yJjDoAZuae/modular-sUAS/README.md

# modular-sUAS
A modular system of components for radio control aircraft and small uncrewed aircraft systems
