yJjDoAZuae/modular-sUAS/doc/design/cowl_interior_surface.md

# Cowl interior surface — the algorithm

*IP-FC-16. Written 2026-08-21, once [OQ-ARCH-17](../architecture/freecad_migration.md#open-questions)
removed the last undecided item.*

The cowl today is a solid blank with channels cut into it. It has no wall
([cowl.md §6.2](cowl.md)), which is sufficient for printing and insufficient for everything
else: a blank has no mass to report, no wall to analyze, and nothing to assemble against.
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
