yJjDoAZuae/modular-sUAS/doc/design/img/cowl_rib_cut/cw24_crowding_section.png

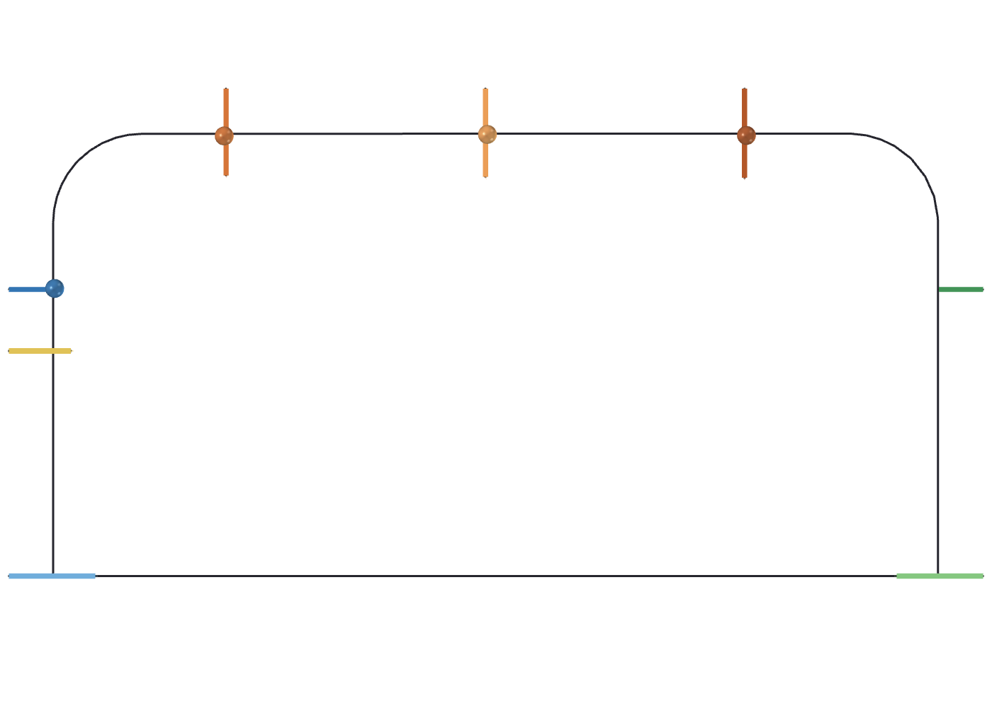
doc/design/img/cowl_rib_cut/cw24_crowding_section.png
