yJjDoAZuae/modular-sUAS/doc/design/img/cowl_rib_cut/cw24_overlap_context.png

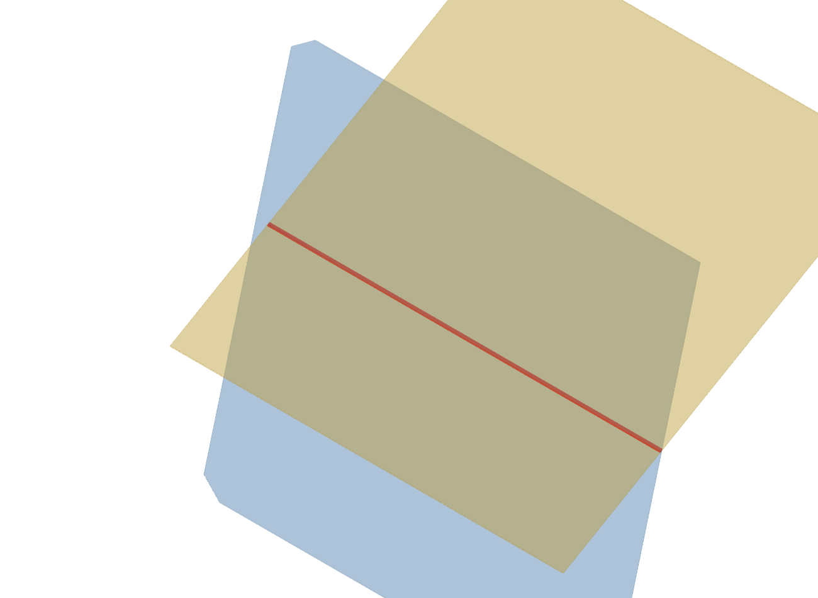
doc/design/img/cowl_rib_cut/cw24_overlap_context.png
