yJjDoAZuae/modular-sUAS/doc/design/img/cowl_rib_cut/cw24_wall_corrupt.png

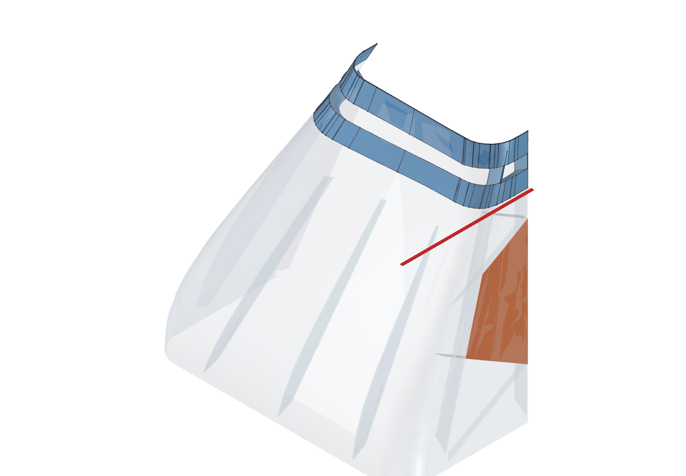
doc/design/img/cowl_rib_cut/cw24_wall_corrupt.png
