yJjDoAZuae/modular-sUAS/doc/design/img/cowl_rib_cut/cw25_section_crossing.png

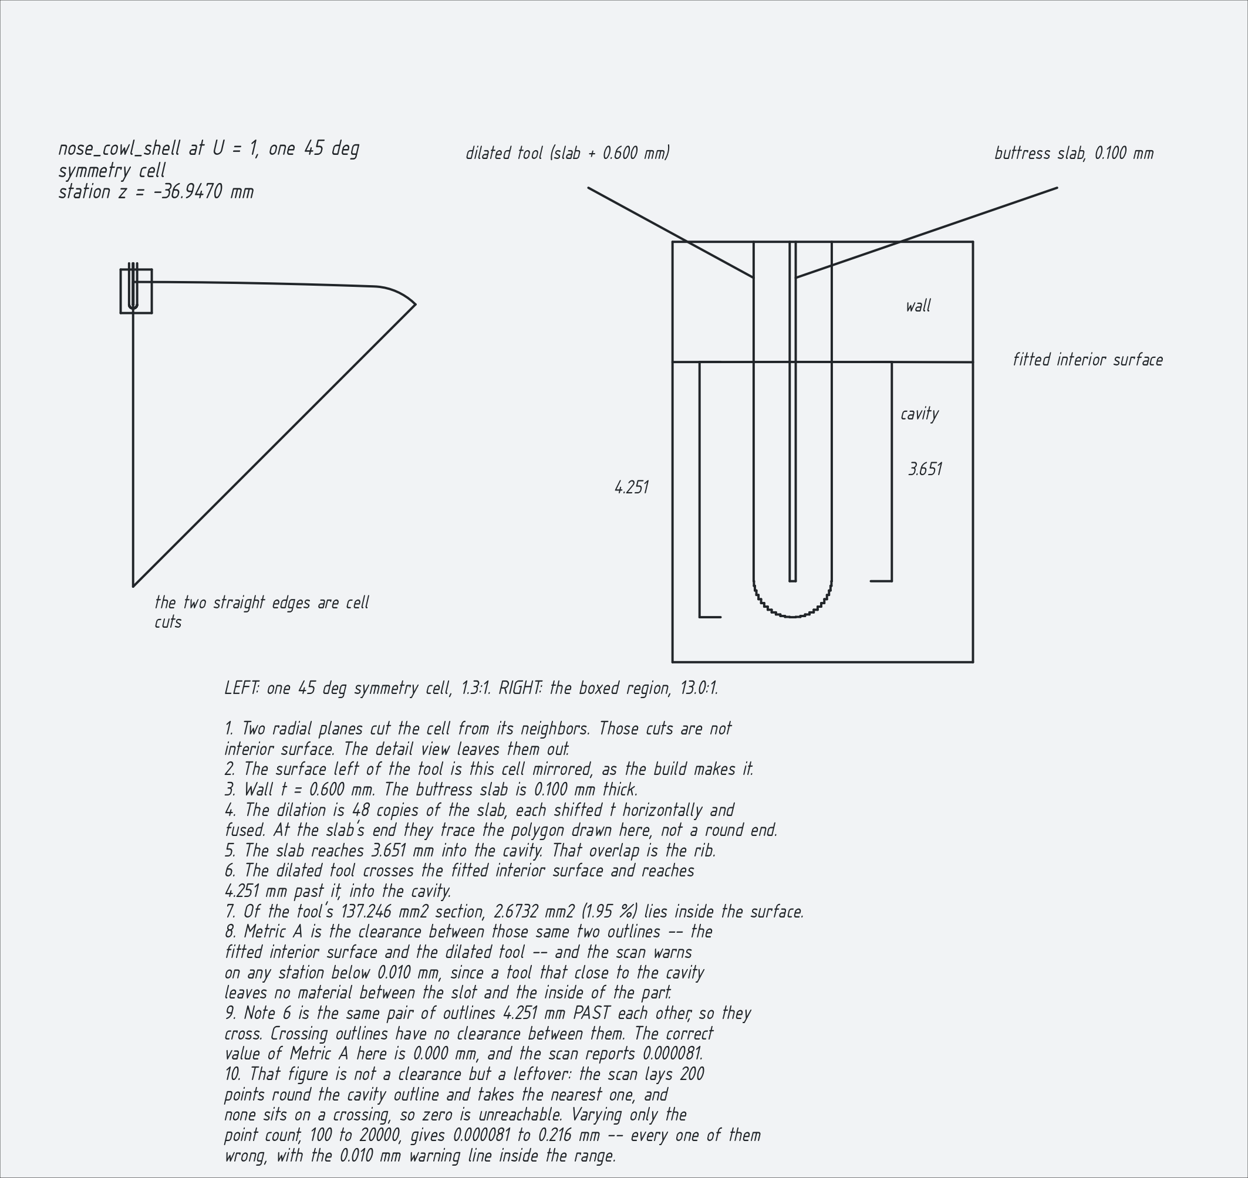
doc/design/img/cowl_rib_cut/cw25_section_crossing.png
