yJjDoAZuae/modular-sUAS/doc/wiki/fd1/media/fuse_splode.png

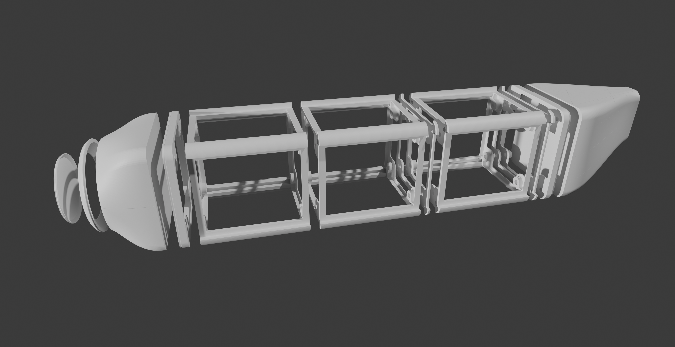
doc/wiki/fd1/media/fuse_splode.png
