yJjDoAZuae/modular-sUAS/media/16mm_collet/16mm_collet_hole_dimensions.png

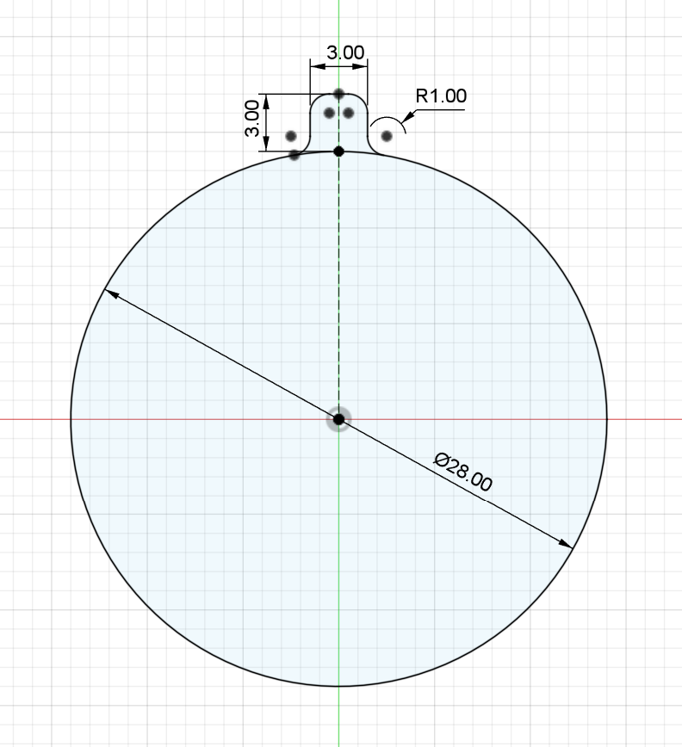
media/16mm_collet/16mm_collet_hole_dimensions.png
