yJjDoAZuae/modular-sUAS/media/16mm_collet/IMG_4695.jpg

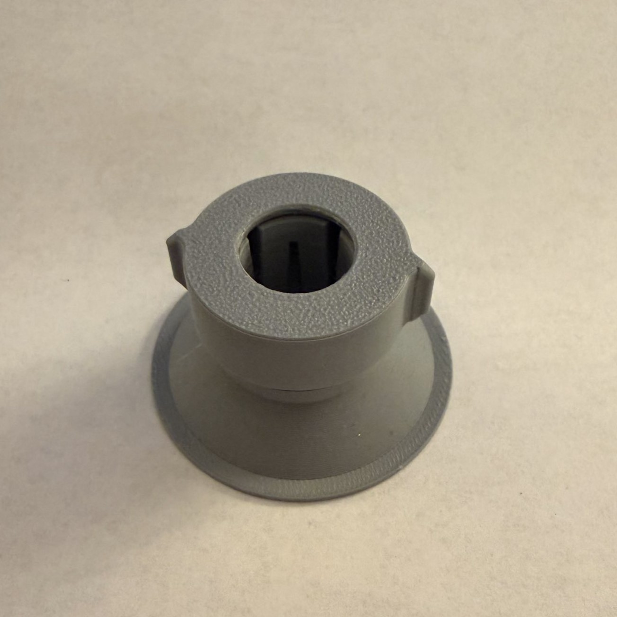
media/16mm_collet/IMG_4695.jpg
