yJjDoAZuae/modular-sUAS/media/boom_clamp/boom_clamp_bushing_outer_dimensions.png

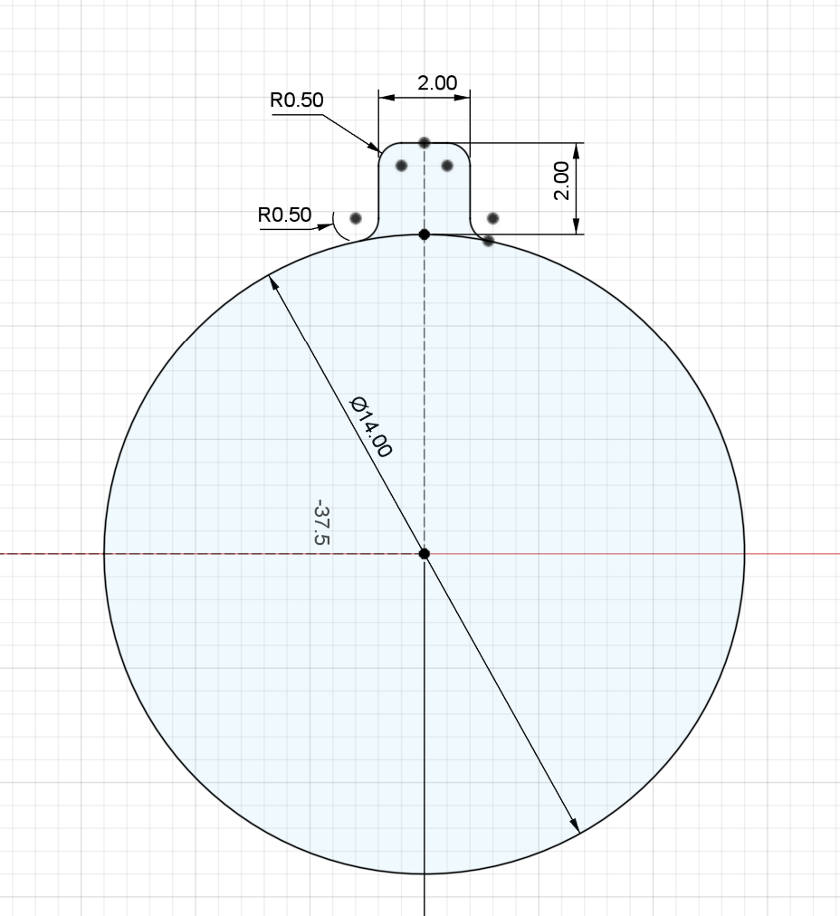
media/boom_clamp/boom_clamp_bushing_outer_dimensions.png
