yJjDoAZuae/modular-sUAS/media/boom_clamp/IMG_4647.jpg

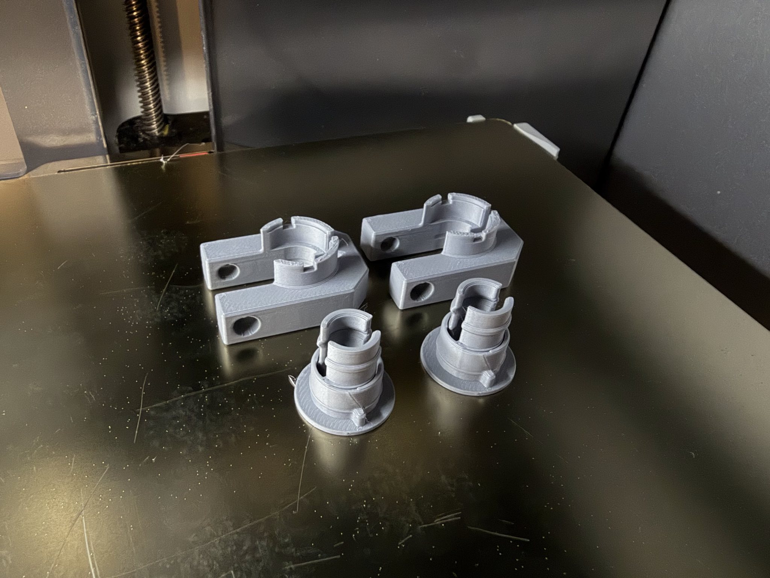
media/boom_clamp/IMG_4647.jpg
