yJjDoAZuae/modular-sUAS/media/boom_clamp/IMG_4653.jpg

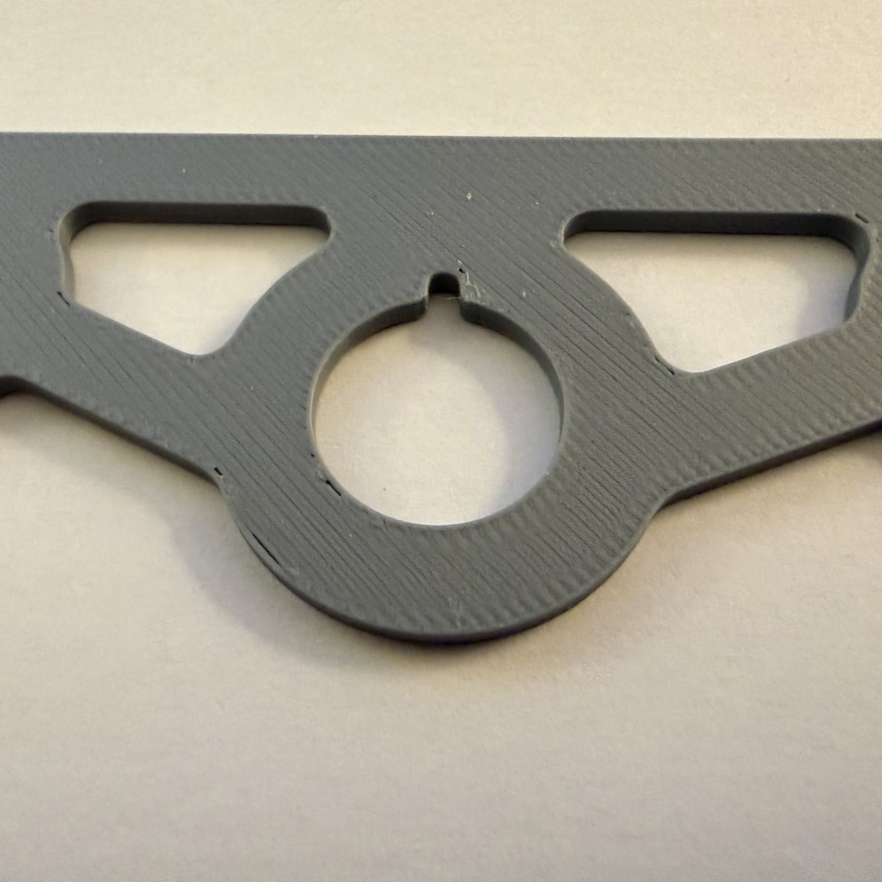
media/boom_clamp/IMG_4653.jpg
