yJjDoAZuae/modular-sUAS/media/boom_clamp/IMG_4656.jpg

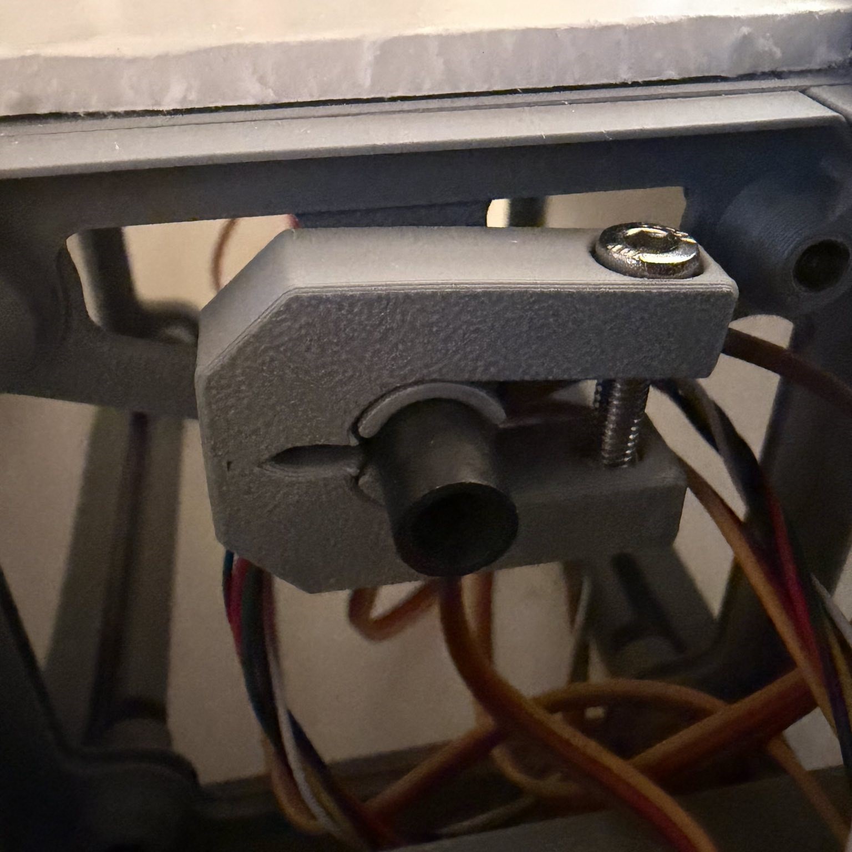
media/boom_clamp/IMG_4656.jpg
