yJjDoAZuae/modular-sUAS/media/bulkhead_corner/IMG_4622.jpg

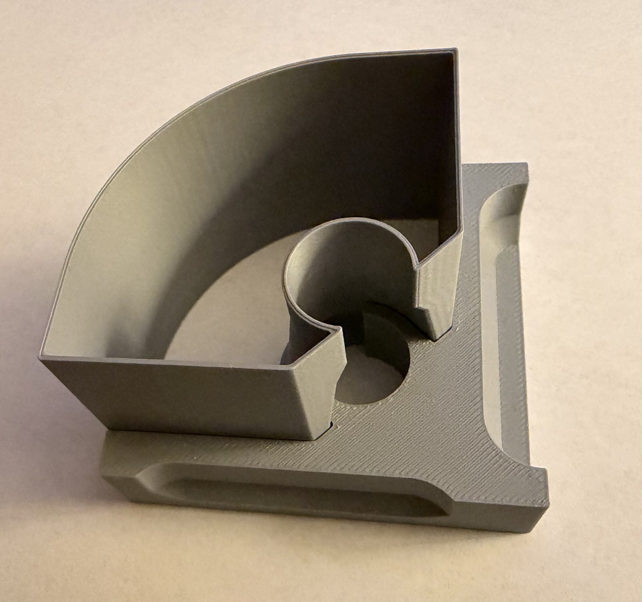
media/bulkhead_corner/IMG_4622.jpg
