yJjDoAZuae/modular-sUAS/media/nose_tail/IMG_4635.jpg

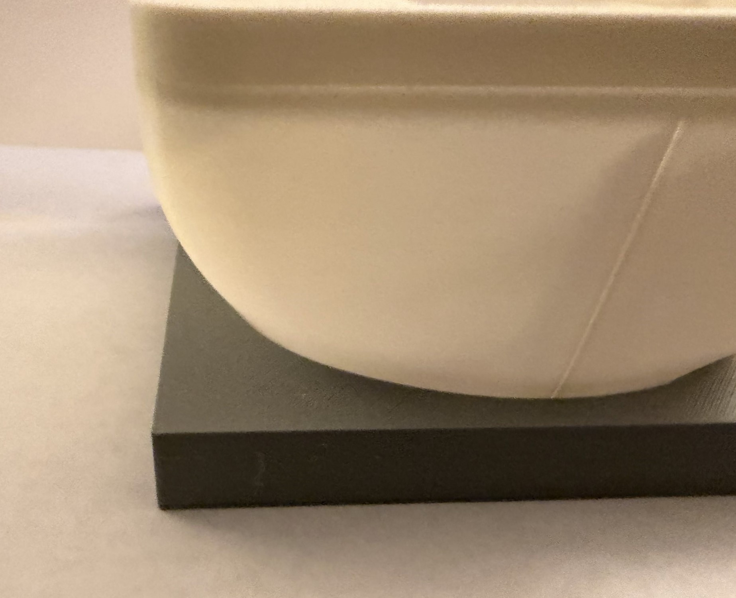
media/nose_tail/IMG_4635.jpg
