yJjDoAZuae/modular-sUAS/media/nose_tail/IMG_4636.jpg

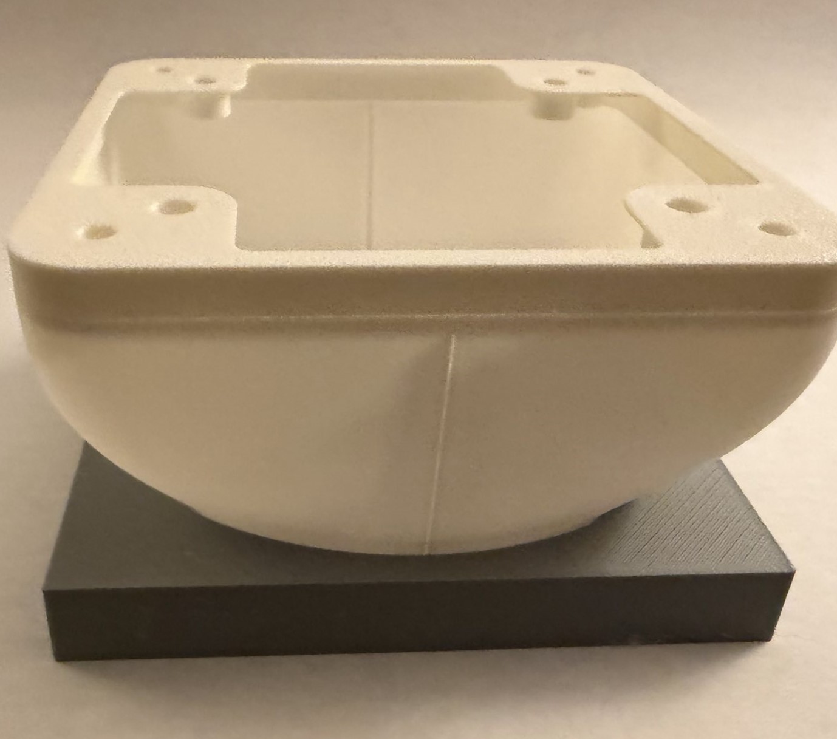
media/nose_tail/IMG_4636.jpg
