yJjDoAZuae/modular-sUAS/media/nose_tail/IMG_4641.jpg

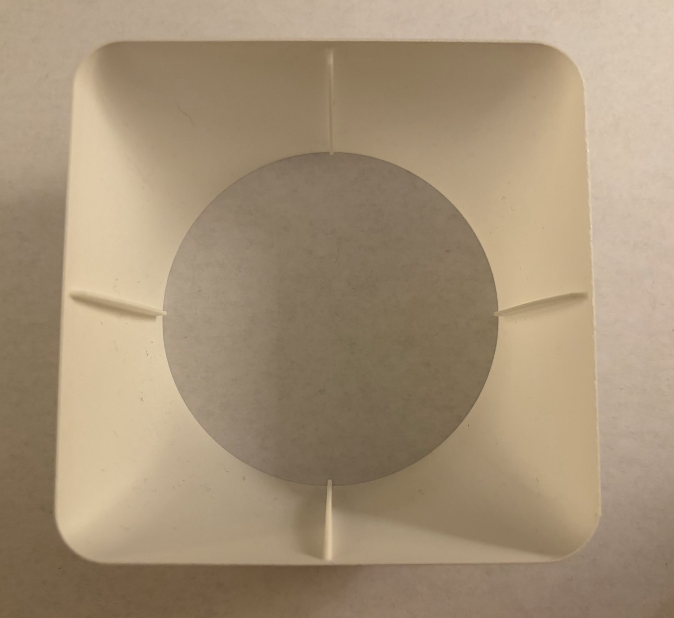
media/nose_tail/IMG_4641.jpg
