yJjDoAZuae/modular-sUAS/media/nose_tail/IMG_4642.jpg

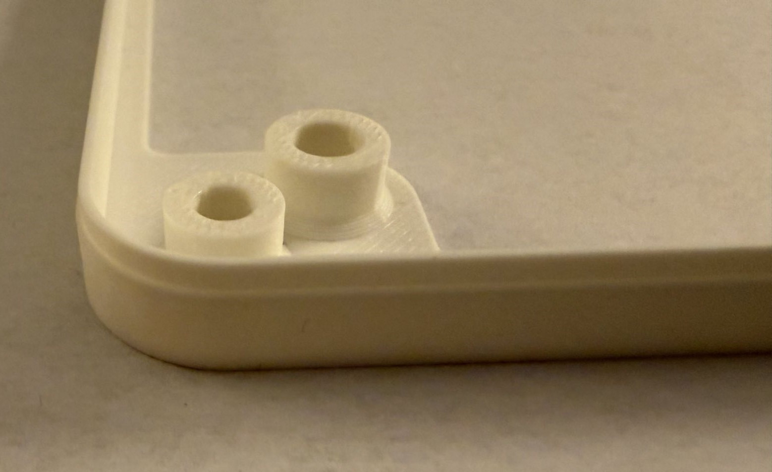
media/nose_tail/IMG_4642.jpg
