yJjDoAZuae/modular-sUAS/media/nose_tail/IMG_4644.jpg

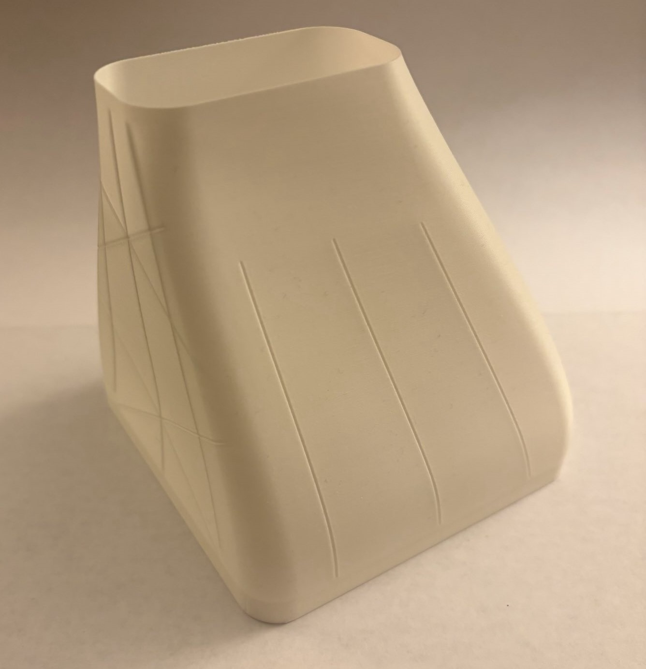
media/nose_tail/IMG_4644.jpg
