yJjDoAZuae/modular-sUAS/media/nose_tail/IMG_4645.jpg

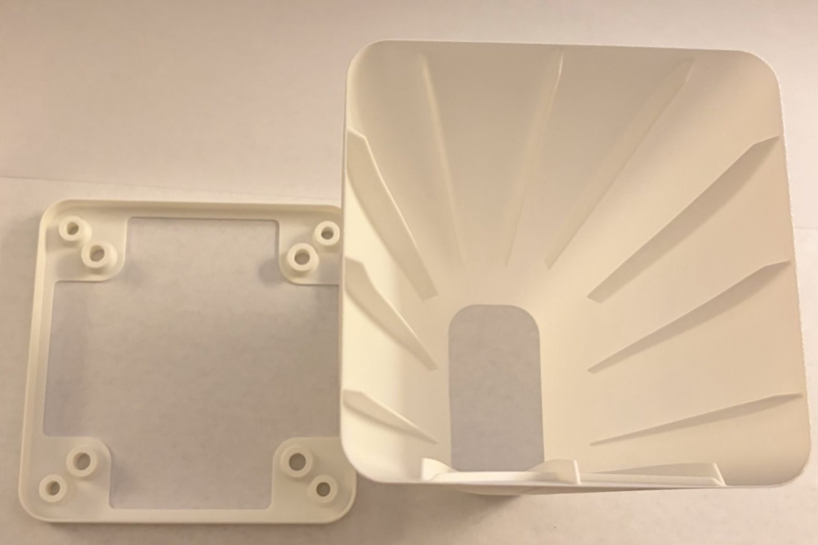
media/nose_tail/IMG_4645.jpg
