yJjDoAZuae/modular-sUAS/media/nose_tail/IMG_4658.jpg

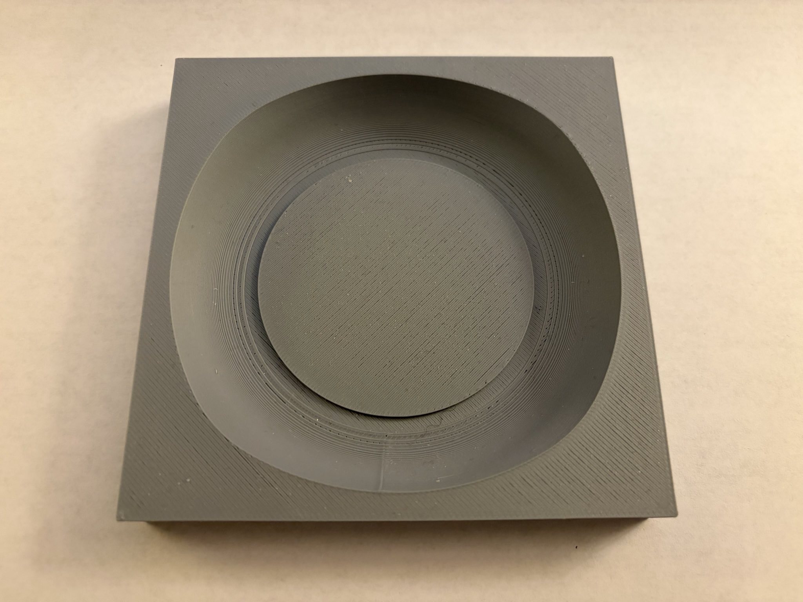
media/nose_tail/IMG_4658.jpg
