yJjDoAZuae/modular-sUAS/media/nose_tail/IMG_4662.jpg

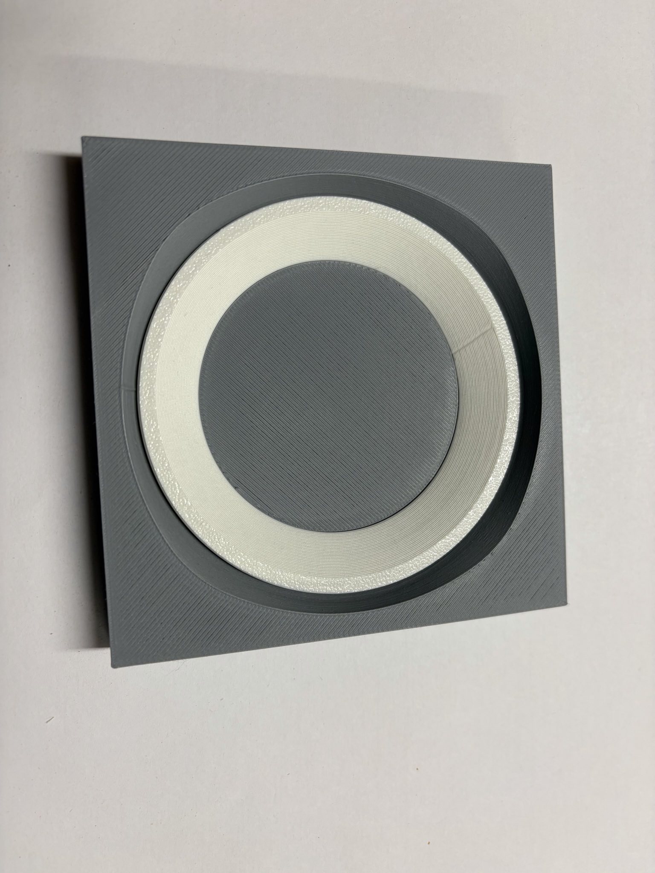
media/nose_tail/IMG_4662.jpg
