yJjDoAZuae/modular-sUAS/media/nose_tail/IMG_4665.jpg

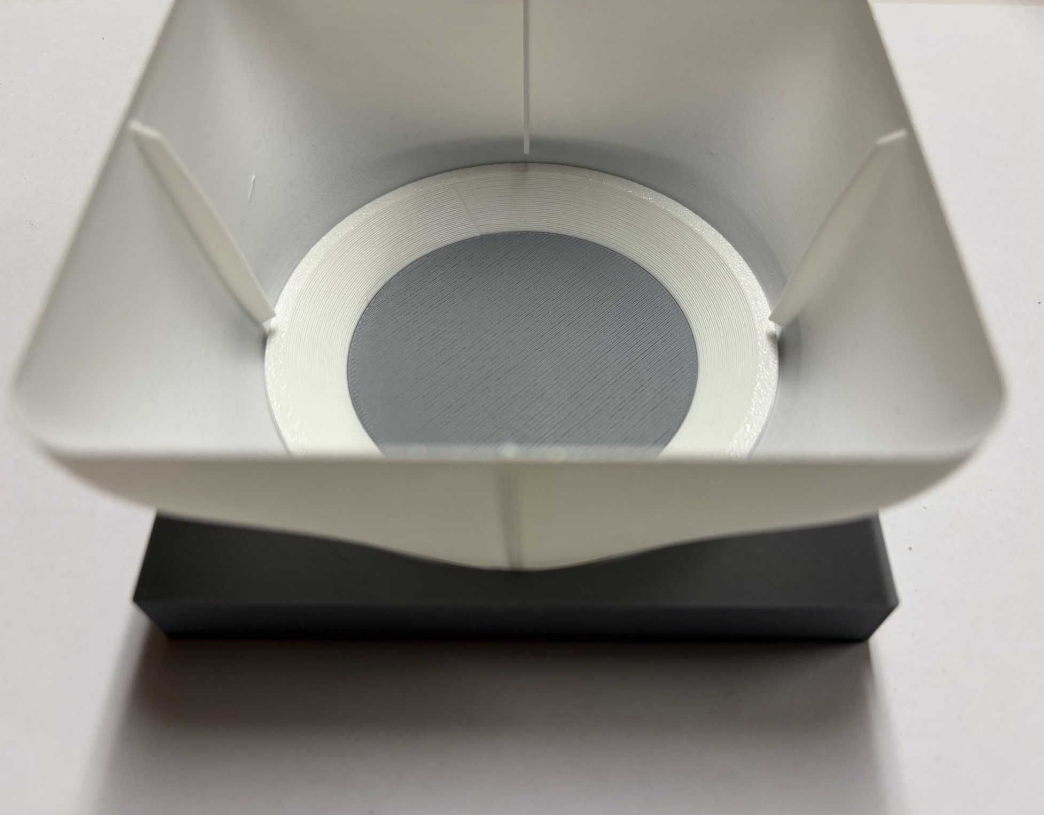
media/nose_tail/IMG_4665.jpg
