yJjDoAZuae/modular-sUAS/media/nose_tail/IMG_4666.jpg

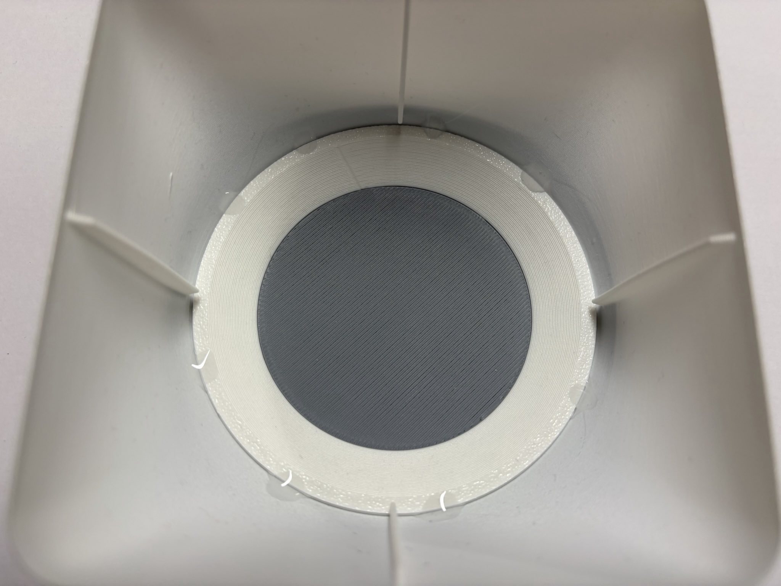
media/nose_tail/IMG_4666.jpg
