yJjDoAZuae/modular-sUAS/media/nose_tail/IMG_4674.jpg

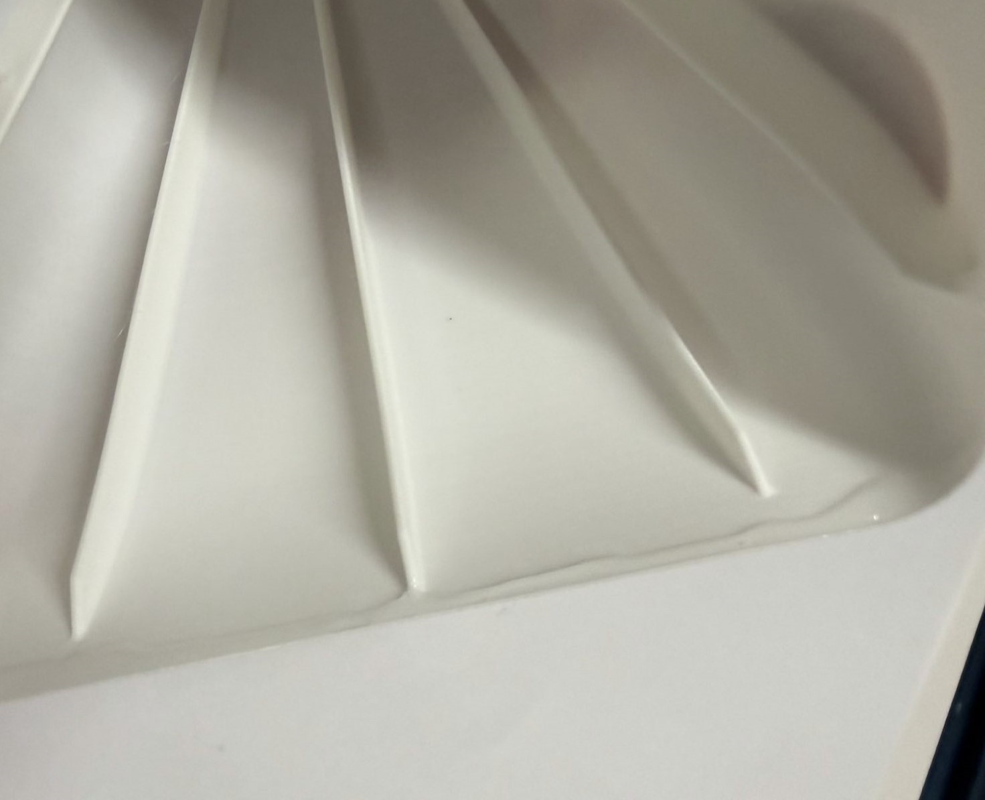
media/nose_tail/IMG_4674.jpg
