yJjDoAZuae/modular-sUAS/media/tmp_splode_blender_red2.png

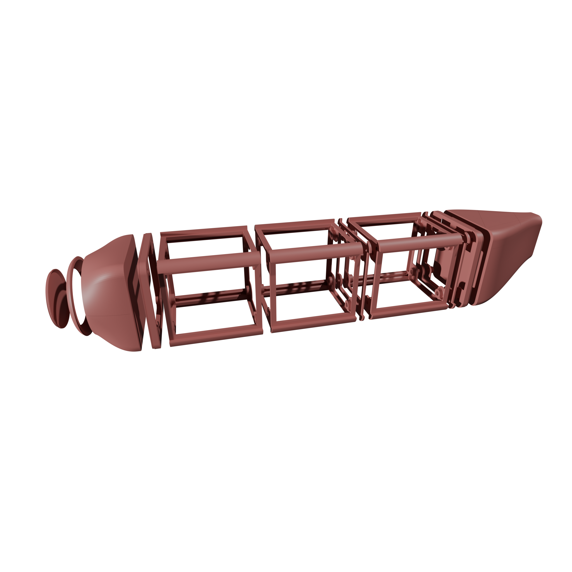
media/tmp_splode_blender_red2.png
