yJjDoAZuae/modular-sUAS/media/tmp_splode_blender_red.png

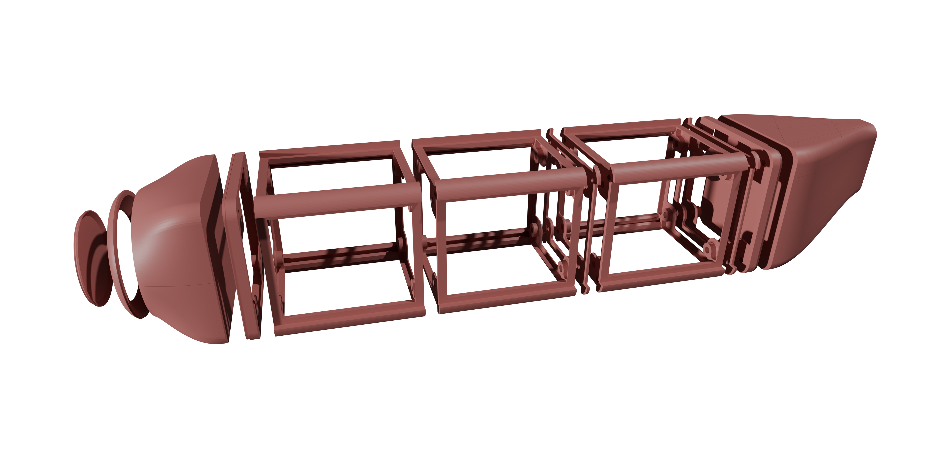
media/tmp_splode_blender_red.png
