yJjDoAZuae/modular-sUAS/src/Fuselage/freecad/ref_corner.stl

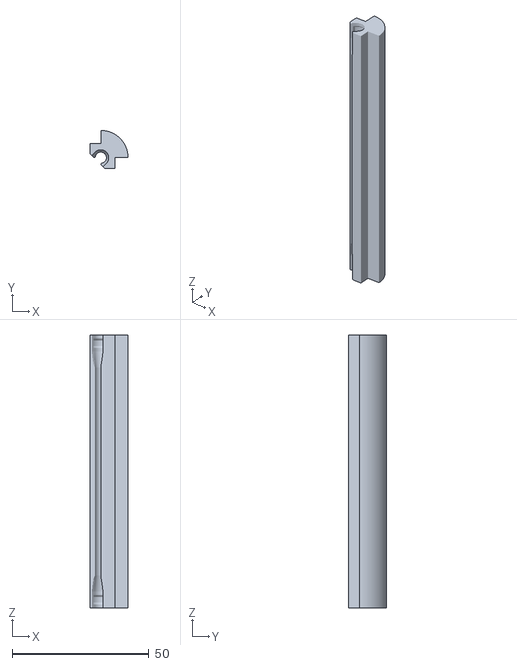
[picture p28: CAD file, 2026-08-09]
src/Fuselage/freecad/ref_corner.stl
14.0 x 14.0 x 100.0
