yJjDoAZuae/modular-sUAS/src/Fuselage/oml/vsp_nose.obj

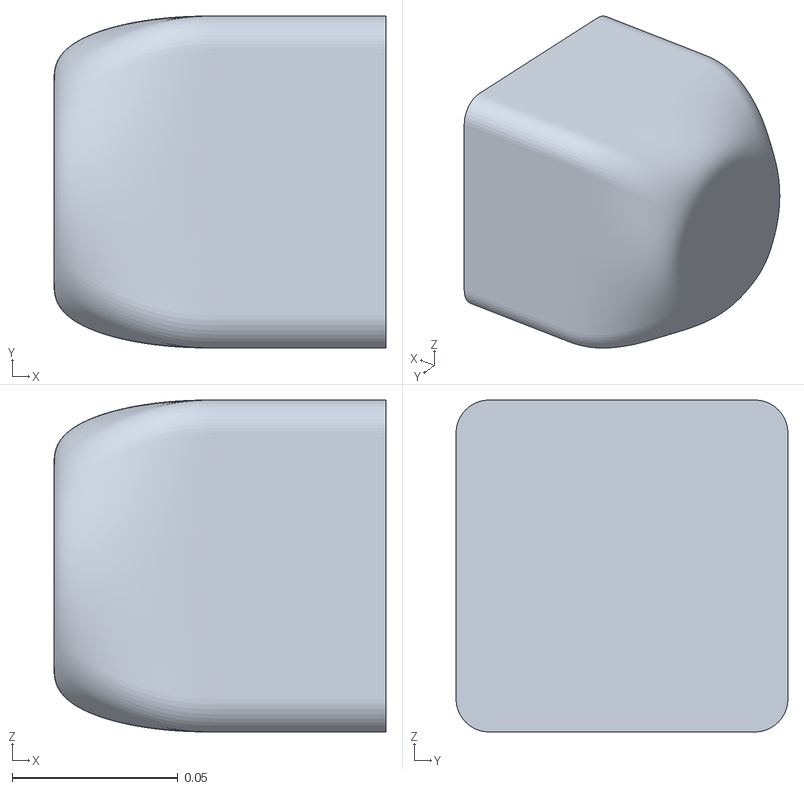
[picture p29: CAD file, 2026-08-04]
src/Fuselage/oml/vsp_nose.obj
0.1 x 0.1 x 0.1
