yJjDoAZuae/modular-sUAS/src/Fuselage/oml/vsp_tail.stl

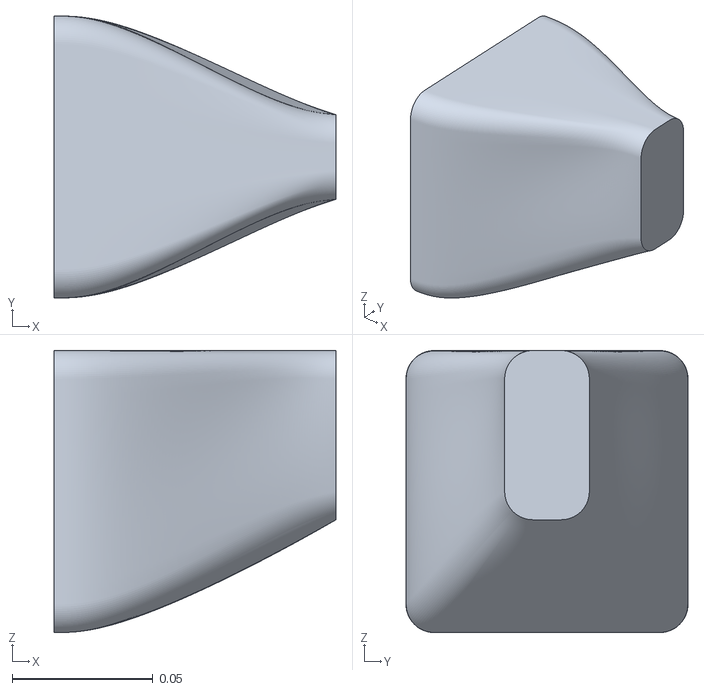
[picture p30: CAD file, 2026-08-04]
src/Fuselage/oml/vsp_tail.stl
0.1 x 0.1 x 0.1
