yJjDoAZuae/modular-sUAS/src/Fuselage/oml/vsp_fuse.obj

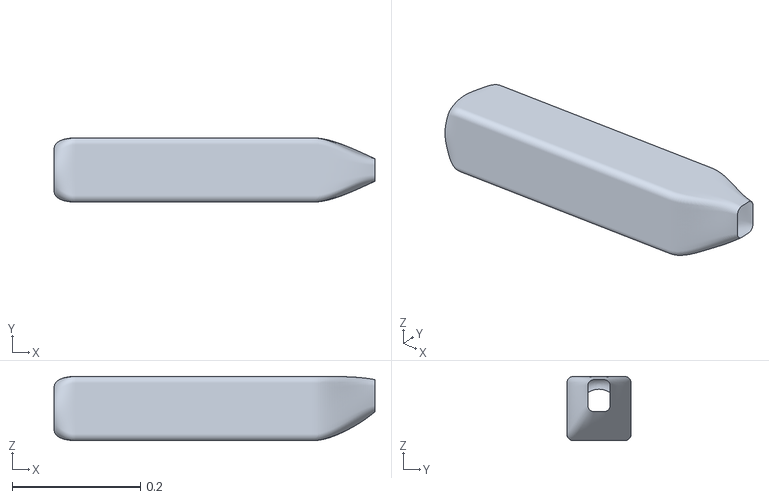
[picture p31: CAD file, 2026-08-04]
src/Fuselage/oml/vsp_fuse.obj
0.5 x 0.1 x 0.1
