yJjDoAZuae/modular-sUAS/src/Fuselage/scad/fuselage_geometry.scad

include <fuselage_corner_geometry.scad>
include <fuselage_bulkhead_geometry.scad>
include <fuselage_boom_bulkhead_geometry.scad>
