yJjDoAZuae/modular-sUAS/(list of files, cad)

Other CAD files:
src/Fuselage/freecad/ref_end_band.scad
src/Fuselage/freecad/ref_transition.scad
src/Fuselage/blender/MAUS-FOS_OML.blend
src/Fuselage/blender/splode.blend
