yJjDoAZuae/modular-sUAS/doc/guidelines/general.md

# General Coding and Development Guidelines

## Development Philosophy

### Project Lifecycle Phase

modular-sUAS is in **initial development**, and additionally in an **adoption** phase: the
Python generators and OpenSCAD geometry under `src/Fuselage/` were copied in from another
repository and are being brought up to standard here. Every interface, parameter file, and
output convention is subject to change without notice.

Consequences for the current phase:

| Rule | Rationale |
| ---- | --- |
| **Never add backward-compatibility shims** — when an interface changes, update every call site directly and delete the old form completely. | No external consumers exist. Compatibility layers are dead weight. |
| **Never reference a previous design in documentation or comments** — describe only the current state. | History lives in version control. Stale design notes mislead future readers. |
| **Generated output is disposable; hand-authored geometry is not.** | `variant_output/` is regenerable by re-running the sweep. `parts/`, `cad/`, and `blender/` contain irreplaceable hand-modeled work. |

Note on the adoption phase specifically: code copied in from the source repository may
contain comments and docstrings that reference commits, paths, or decisions from *that*
repository's history, which did not come across. Treat such references as unverified until
checked against this repository.

---

### Test-Driven Development (TDD)

New functionality, and every change to existing functionality, follows the
**Red-Green-Refactor** cycle:

1. **Red** — Write a failing test that defines the desired behavior.
2. **Green** — Write the minimal code required to pass the test.
3. **Refactor** — Clean up the implementation without changing behavior, keeping all tests
   green.

Rules:

- No production code is written or changed without a test that motivates it. There is no
  exemption for code that was inherited rather than written here — see below.
- Each test covers exactly one behavior or requirement.
- Tests must be fast, isolated, repeatable, and self-validating.
- Aim for a test pyramid: many unit tests, fewer geometry tests, few full-sweep tests.
- **Verification that is not committed as a test is not verification.** A scratchpad
  script, a one-off `freecadcmd` session, or a manual measurement establishes that a change
  works once, on one machine, in one session. It proves nothing to the next person who
  touches the code and nothing to anyone re-running the check later, because there is
  nothing left to re-run. Before a change is considered done, whatever was done to confirm
  it works is rewritten as a committed test in one of the two tiers below. This applies
  equally to a human's verification and to Claude's — a change is not done because a
  throwaway script printed the right numbers once.

**There is no adoption-phase exemption.** *Retracted 2026-09-22: this section previously
exempted "inherited" code — copied in from another repository — from needing tests until a
single-part entry point existed, and filed retrofitting as background roadmap work rather
than a precondition for touching that code. In practice that exemption was used to make
real functional changes to inherited geometry code (`cowl_tree.py`, `cowl.py`,
`fuselage_variants.py`) across multiple sessions with no committed test at all — only ad
hoc scratchpad scripts, discovered and rejected on 2026-09-22. Retrofitting a test onto
inherited code before changing it **is** the Red step: write a test that pins the
function's current, correct behavior, confirm it is Green against the unmodified code, and
only then make the change. Where the single-part entry point a test needs does not exist
yet, building it is the first Red/Green cycle, not a reason to skip the cycle. The backlog
of inherited code that still has no test is tracked in
[doc/implementation/test_coverage.md](../implementation/test_coverage.md).*

### Two test tiers, because two Python interpreters are involved

This project's code runs in two interpreters, and **the reason is an ABI version lock, not an
inherent limit.** FreeCAD 1.1.3 embeds CPython 3.11 and ships `python311.dll`; the project venv is
3.13. A `.pyd` extension module is compiled against one specific CPython version, so importing
`Part` from the venv fails in the loader before any FreeCAD code runs — `ImportError: Module use of
python311.dll conflicts with this version of Python.` Measured 2026-10-05 with FreeCAD's `lib` on
`sys.path` and both `bin` and `lib` registered via `os.add_dll_directory`, so it is not a
search-path failure. OpenVSP is pinned the opposite way: its `_vsp.pyd` works under 3.13 and fails
under 3.11, and it is not a pip dependency, so there is no wheel to re-resolve.

**The split is therefore a cost decision, not a law.** Running everything under FreeCAD's own
bundled 3.11 interpreter works — both `FreeCAD` and `Part` import, and 865 of the 873 pytest tests
pass there — but it breaks the eight OpenVSP tests and would tie the project's Python version to a
CAD vendor's build choice. **The project chooses its own interpreter** (OQ-ARCH-22,
[freecad_migration.md](../architecture/freecad_migration.md)), so the two tiers stay, bridged by a
process boundary rather than merged. See
[geometry_bridge.md](../architecture/geometry_bridge.md).

Neither tier is optional or lesser than the other:

| Tier | Location | Runs under | Covers | Convention |
| --- | --- | --- | --- | --- |
| Unit / integration (pytest) | `tests/` | The project venv (`uv run pytest`) | Pure-Python logic and anything importable in the venv — parameter dataclasses, sweep logic, CSV/JSON handling, drawing-family lookups, comparison and measurement helpers under `src/Fuselage/tools/` | `test_<subject>_<condition>_<expected>` functions, `assert` / `pytest.approx`. See [python.md](python.md#testing-python). |
| Integration (`freecadcmd`) | `src/Fuselage/freecad/check_*.py` | `freecadcmd` (FreeCAD's bundled interpreter) | FreeCAD document and geometry code: `cowl_tree.py`, `cowl.py`, `cowl_interior.py`, `corner_tree.py`, `oml_blank.py`, `bulkhead_*.py`, `boom_*.py`, `drawing*.py`, and everything else under `src/Fuselage/freecad/` | Standalone script, one `check_<subject>()` function per concern, printed pass/fail lines, a `bad` counter returned as the process exit code, guarded by `corner_common.is_entry_point(__name__)` — `freecadcmd` never triggers a bare `if __name__ == '__main__':` guard, so every check script uses that helper instead. |

**A third tier, the geometry bridge, is where new geometry tests go.** `pytest` cannot *import*
FreeCAD, for the ABI reason above, but it can drive it across a process boundary: a worker runs
under the vendor's interpreter and the test holds vendor objects by reference. That gives named
cases, fixtures, `@pytest.mark.parametrize` and `pytest.raises` for geometry code, at 0.9 ms per
operation, with an expensive build paid once per session. The design is
[geometry_bridge.md](../architecture/geometry_bridge.md).

**Which tier a new geometry test goes in (OQ-GB-2, decided 2026-10-06).** A new geometry check is a
`pytest` function in the bridge tier. It becomes a `check_*.py` script only when what it produces
is a report a person reads rather than a set of assertions — in practice the whole-part parametric
builds that take minutes and print a table. **Being document-driven is not a reason to make it a
script:** the bridge supports attribute assignment specifically so document-driven tests can be
bridge tests. The existing `check_*.py` scripts are not being converted; a quarter-hour build whose
output is a report is well served by a standalone script.

The older claim that a FreeCAD geometry function's test can *only* be a `check_*.py` entry,
"because it never will be" importable under pytest, was wrong on the mechanism and is withdrawn.
What remains true is that `pytest` never imports FreeCAD directly.

**A `sys.exit()` with buffered stdout loses the whole report under `freecadcmd`.** Found
2026-09-22 writing `check_plane2d.py`: `if is_entry_point(__name__): sys.exit(main())`
produced no output at all — not even a traceback — although `main()` genuinely ran and
printed a full report (confirmed by importing the module and calling `.main()` directly from
a throwaway wrapper, which showed the real output). `freecadcmd`'s embedding of Python does
not flush stdout on the way out when the process exits via `SystemExit`. Always flush first:

    if is_entry_point(__name__):
        _code = main()
        sys.stdout.flush()
        sys.exit(_code)

already the pattern in `check_derived_geometry.py` and several others — copy it rather than
`sys.exit(main())` directly, which silently produces a check that looks like it printed
nothing rather than one that failed.

A script named `test_<module>.py` that is not a real pytest test file — that has no
`test_*` functions and asserts nothing — is a naming-convention violation, not a
placeholder. `src/Fuselage/tools/test_fuse.py` is exactly this: a three-line scratch import
with a name that claims to be this project's test coverage for `fuselage_bulkhead.scad`
and is not. See [doc/implementation/test_coverage.md](../implementation/test_coverage.md).

### Testing geometry generators

Applies to both tiers above:

- **Assert on measured model properties**, never on byte-identical `.scad`/`.stl` output or
  FreeCAD document XML. Generated output is not stable across library versions,
  floating-point rounding, or facet-count settings. Assert on bounding box, overall
  dimensions, volume, triangle/face count within a tolerance, solid validity, and the
  presence or absence of a feature.
- **Never verify by running the full sweep.** It is expensive and it overwrites
  `variant_output/`. Tests operate on a single parameter combination.
- **Pin the parameter combination** that exposed any bug you fix, as a regression test, in
  whichever tier the fixed code lives in.
- Floating-point comparisons use an explicit tolerance appropriate to the geometry —
  an explicit tolerance meaningful at the scale of the feature being measured. At SI scale a
  part dimension is order 0.1 m and a print tolerance is order 1e-4 m, so a default relative
  tolerance is usually wrong — state the absolute tolerance. A verification tolerance
  measures agreement between two computations of the same geometry; it is not a
  manufacturing fit, and must not be reused as one.

### The documentation has invariants, and they are checked by running something

`python src/Fuselage/tools/doc_check.py` checks the bookkeeping the design and implementation
documents carry by convention: every anchored link resolves, an open-question summary table
lists exactly the questions still open, a `blocked` work item names its blockers in the status
cell and those blockers are really unfinished, every work item's status is in the vocabulary,
every `IP-`/`OQ-` id mentioned exists, and the prose is American English. `tests/test_doc_check.py`
runs it over the tree, so a document that drifts fails the suite rather than waiting to be
noticed.

**Run it after editing a document, and read what it says rather than assuming.** Its first run
reported 320 findings and 27 of those were the checker's own false positives -- a question
reported resolved because the word "fixed" appeared in its title, a correct link reported broken
because the slug function trimmed a space GitHub keeps. A finding is a place to look, not a
verdict. `--fix-spelling` is the one class it will repair on its own; everything else needs a
person to decide what the document should say.

`python src/Fuselage/tools/source_spelling.py` is the same rule for the code -- comments,
docstrings, messages and **identifier names**, sharing the one dictionary so the two cannot
disagree. A compound is renamed only if it is listed in its `RENAMES` map, because there is no
word boundary before the `centre` in `_face_centre` and a bare replacement would reach a
definition without reaching its call sites. **A British stem inside a longer token with no entry
is reported, not changed** -- add the entry, do not widen the pattern. `--fix` applies it.

Editing a comment in a geometry source is not free: `geometry_version` digests file bytes on
purpose, so the next `--resume` sweep re-renders those parts. That is the cheap direction and
the tool's own note says why.

### Capability belongs in the durable code, not the throwaway tool

**A one-off script may orchestrate durable code. It must not be where the durable code
lives.** When a temporary tool needs a capability the main codebase lacks, add it to the
main codebase and have the tool call it. Do not implement it in the tool.

This is not a style preference; it has already cost this project real work. A migration tool
written for a transient refactor — correctly treated as disposable, and discarded once the
refactor finished — had accumulated six capabilities the parametric sweep still needs:

| Capability | Why it mattered |
| --- | --- |
| Parallel rendering | The sweep used 1 of 6 cores without it |
| Memory-aware worker count | Without it, concurrent renders exhaust RAM and abort mid-run |
| Resume / skip-if-done | An interrupted sweep restarts from zero |
| Mesh measurement with truncation detection | A half-written STL otherwise looks complete |
| Property-based geometry comparison | The only sound way to diff generated meshes |
| Family completeness checking | Totals look right while one variant family is short |

None of it lived in `fuselage_variants.py`. All of it went with the tool, and the loss stayed
invisible until the sweep was run again and observed to be single-threaded.

**How to tell the difference.** Ask whether the capability is about *this task* or about *the
thing being operated on*. Moving files, journalling a plan, resuming an interrupted move —
those belong to the migration. Rendering geometry faster, verifying a mesh is complete,
comparing output against a reference — those belong to the geometry pipeline, whatever
happens to be calling it today.

**The wrapping test.** If a tool has to monkeypatch, shim, or shadow the main code to get its
behavior, the behavior is in the wrong place. That migration tool replaced
`fuselage_variants.subprocess.check_call` and `fuselage_variants.solid_render` at runtime.
Both should have been documented parameters on `fuselage_variants` that the tool passed
arguments to — at which point discarding the tool would have cost nothing.

### Weigh a refactor against what replaces the code

Before improving something, ask whether it survives. Work that only makes scheduled-for-
deletion code nicer to *read* is spent twice: once doing it, once discarding it — and in
between it carries the full risk of changing behavior.

This is the general form of the unit exemption above, which is one instance of it. The
test is not "is this better?" but **"does this survive the next phase, and does it make
that phase easier?"**

Three outcomes, and they are treated differently:

- **Survives the port** — Python parameter handling, sweep logic, validity checks,
  verification tooling, design documentation. Improve freely; this is where effort
  compounds.
- **Does not survive, but makes the current phase safe to operate** — worth doing, in
  proportion. Making a 28-argument call keyword-based prevents silently wrong parts
  during the months the path is still in use, which is a different justification from
  tidiness.
- **Does not survive and only improves readability** — decline it, and say why.

A worked example, because the distinction is easy to lose. Grouping the OpenSCAD
modules' parameters into vectors was planned, scoped, and started before anyone asked
whether it survived Phase 3. It does not: the parameter groups already exist on the
Python side, and what the refactor actually builds is an *encoding* of them in OpenSCAD
vectors plus accessor functions to make that encoding safe — both workarounds for
OpenSCAD's lack of records, and both discarded the moment generation moves to FreeCAD,
where a group is a dataclass. The equivalent work on the Python side does survive, and is
what got done instead. See OQ-GEO-1 in
[doc/implementation/geometry_refactor.md](../implementation/geometry_refactor.md).

Note that this cuts against the instinct to tidy what you are reading. A file being
unpleasant is not, on its own, a reason to change it — check the roadmap first.

### SOLID Principles

| Principle | Summary |
| --- | --- |
| Single Responsibility | A module or function has one reason to change. |
| Open/Closed | Open for extension, closed for modification. |
| Liskov Substitution | Subtypes must be substitutable for their base types. |
| Interface Segregation | Prefer narrow, focused interfaces over wide ones. |
| Dependency Inversion | Depend on abstractions, not concretions. |

---

## Naming Standards

Clear, unambiguous naming is mandatory. Names must communicate intent without requiring a comment.

### General Rules

- Names must be descriptive and self-documenting.
- Abbreviations are forbidden. The only permitted abbreviations are those that are the
  canonical name in this domain: `oml` (outer mold line), `maus` (Modular Airframe Unitized
  System), `fos` (Fuselage Outer Standard), `suas` (small uncrewed aircraft system), `stl`,
  `csg`, `vsp` (OpenVSP), `cad`, `fem`. The unit multiplier `U` is an established project
  symbol and is permitted. All other abbreviations are forbidden, including informal
  shorthand (`bulk`, `param`, `tmp`, `geom`) and single-letter identifiers.
- Boolean names must read as a predicate: `is_anchor`, `has_boom`, `can_print_unsupported`.
- Names must not encode type information (no Hungarian notation).
- Acronyms are treated as words in `PascalCase` identifiers: `OmlMesh`, not `OMLMesh`.

### Naming by Category

| Category | Convention | Example |
| --- | --- | --- |
| Python classes / types | `PascalCase` | `BulkheadType`, `CowlDefinition` |
| Python functions / variables | `snake_case` | `run_bulkhead_parametric_sweep()`, `corner_radius` |
| Python constants | `SCREAMING_SNAKE_CASE` | `SCAD_DIR`, `PARAM_DIR` |
| Python private attributes | `_snake_case` | `_here`, `_root` |
| Python modules / packages | `snake_case`, lowercase | `fuselage_variants.py` |
| OpenSCAD modules and functions | `snake_case` | `fuselage_corner_geometry()` |
| OpenSCAD file names | `snake_case.scad` | `shape_modifier_utils.scad` |
| Parameter CSV columns | `snake_case`, `VID_` prefix for the variant ID | `VID_bulkhead_type`, `bulkhead_type_name` |
| Pytest test files (`tests/`, venv tier) | `test_<module>.py` | `test_fuselage_variants.py` |
| `freecadcmd` check scripts (`src/Fuselage/freecad/`, FreeCAD tier) | `check_<subject>.py` | `check_cowl_interior.py` |

### Unit Encoding in Names

When units are not obvious from context, encode them in the name:

```python
corner_radius_m: float
overhang_angle_rad: float
extrusion_width_m: float
```

The unit multiplier `U` is dimensionless — name what it scales, not `U` itself.

**Name the quantity you actually mean.** `extrusion_width` above was called
`nozzle_diameter` until IP-GEO-24, and every use of it was a wall *N* beads thick or *N*
beads of margin — never the nozzle's bore. The two are numerically close, which is how it
survived, and different quantities, which is why it had to be fixed before the FreeCAD
port read the old name and reproduced it.

---

## Units — SI Is the Project Standard

**Every internally stored value uses SI base units: meters (m), seconds (s), kilograms
(kg), and radians (rad).**

This applies to every variable, field, parameter, function argument, and return value in
the project. Non-SI units exist **only at the immediate file interface** — the narrow layer
that reads a parameter file or writes a geometry file — and never propagate inward.

| Quantity | Unit | Symbol |
| --- | --- | --- |
| Length / distance | meter | m |
| Angle | radian | rad |
| Time | second | s |
| Mass | kilogram | kg |
| Area | square meter | m² |
| Volume | cubic meter | m³ |
| Force | newton | N |
| Pressure / stress | pascal | Pa |
| Density | kilogram per cubic meter | kg/m³ |

### The file interface — where conversion is allowed

Conversion happens at exactly these boundaries, and nowhere else:

| Boundary | Direction | Conversion |
| --- | --- | --- |
| Reading a parameter CSV or shape JSON | in | Declared unit → m, rad |
| Emitting `.scad` source | out | m → mm, rad → deg |
| Reading or writing STL / 3MF | both | m ↔ mm |
| FreeCAD scripting (Phase 3) | both | m ↔ mm; FEM additionally N/mm² ↔ Pa |
| Display, reports, drawings | out | m → whatever the reader needs |

**Exported meshes must be in millimeters.** STL and 3MF carry no unit metadata — a slicer
interprets the numbers as millimeters, full stop. An STL exported in meters loads as a part
1/1000 of its intended size and is silently unprintable. This is a hard output requirement,
not a convention that can be revisited.

So the emission layer scales SI → mm on the way out, and that conversion belongs in **one
named function** in the render path, not scattered through geometry code. Round-trip any
mesh the project re-imports (the OML meshes in `oml/` are millimeters on disk) back to SI on
the way in.

FreeCAD's FEM stack works in mm/N/MPa, which is internally self-consistent
(`1 MPa = 1 N/mm²`). Treat that whole stack as file-interface: convert to SI on the way out
of it, and never let mm/MPa values into project code.

### Enforcement

- Variable names **should** encode units when not obvious: `corner_radius_m`,
  `overhang_angle_rad`.
- Imperial parameter axes exist (`imperial` panel variants, fractional-inch panel
  thicknesses). Convert to meters **at the point the CSV is read**, and carry only SI
  thereafter. Never propagate a mixed-unit value inward.
- Conversion helpers live in one module. Never call a conversion function inside geometry
  or analysis code — if you need one there, the boundary is in the wrong place.
- The unit multiplier `U` is dimensionless; what it scales is in meters.

### Scope — what this standard governs, and what it does not

The SI standard above applies to:

- **All new code**, from the first line.
- **The FreeCAD port** (roadmap Phase 3), which is new code and is where the standard
  actually lands across the geometry pipeline.
- **Analysis, optimization, and solver work** in any language.
- **Any future refactoring target** — when a module is genuinely rewritten, it comes back SI.

It does **not** apply to the **OpenSCAD artifacts**: the `.scad` sources, the parameter
axis CSVs as populated, the JSON shape definitions as authored, and the exported meshes. It
**does** apply to the Python that derives a variant's parameters and drives the sweep.

### ⚠ The OpenSCAD artifacts stay in millimeters. Do not convert them.

The generators copied in from the source repository work in **millimeters throughout** —
`standard_values()` returns `unit_width = 100`, `unit_length = 100`, `corner_radius = 10`,
`longeron_radius = 2` and `bolt_offset = 8`; `PrinterSettings` defaults to
`extrusion_width = 0.4` and `layer_height = 0.2`; and every parameter axis CSV is
populated to match.

**That is a deliberate exemption, not technical debt, and its purpose is traceability.** The
`.scad` sources are the record of the original design, and they stay in millimeters so the
implementation remains checkable against it. That is the whole of the reason, and it does not
expire when the sweep does — which is why the exemption is stated here as a list of
artifacts rather than as a transitional allowance.

A second, independent reason to leave the artifacts alone: the unit regime is load-bearing
across every `.scad` module, every CSV axis and every JSON shape definition at once, and a
partial conversion produces geometry that is wrong by a factor of 1000 in one dimension,
renders cleanly, and exports without error.

#### What the exemption does not cover

**The Python that derives parameters is ordinary project code and is in scope of the SI
standard.** `derived_parameters()` in `tools/fuselage_variants.py` is the case that made this
ambiguous and is settled by
[freecad_migration.md, OQ-ARCH-25](../architecture/freecad_migration.md#open-questions): it
operates in meters, the parameter CSV read converts in, and the `.scad` emission converts out
— which is exactly what the file-interface table above already prescribes. Nothing about
the artifacts changes.

**Superseded wording, 2026-11-07.** This section previously said *"Never convert existing sweep
code to SI, as a task or as a side effect of one"* and *"New code that consumes the sweep's
output converts mm → m at its own boundary and says so, rather than reaching in and
changing the source."* Read literally, both covered Python as well as `.scad`, and the first
was cited as forbidding the conversion OQ-ARCH-25 then decided on. The rules below say the same
thing about the artifacts and no longer say it about the code around them.

**Rules:**

- **Never convert an exempt artifact** — a `.scad` source, a parameter axis CSV, a JSON
  shape definition, an exported mesh — as a task or as a side effect of one.
- **Do not "fix" a `_mm` name to `_m`** in one. The name is accurate; the value really is
  millimeters.
- **The Python is in scope.** A module that derives, resolves or drives is SI like any other,
  and converts at the boundary where it writes an artifact or reads one. Check the module's
  declared regime in [`tools/unit_regime.json`](../../src/Fuselage/tools/unit_regime.json)
  rather than assuming the whole directory is exempt: a module with no declaration is `si`.
- **The gate on any change upstream of emission is byte-identical `.scad` output**, not
  agreement within a tolerance. Traceability is the reason for the exemption, so the test has
  to be that the artifact did not move at all — and the sweep's own `--resume` staleness
  key hashes the definition file, so anything less marks every part stale.
- New code that *consumes* an exempt artifact converts at its own boundary and says so.
- When touching an inherited file, state its unit regime in a comment at the top rather
  than assuming a reader will know.

The divergence is recorded in the roadmap so it reads as a decision rather than an
oversight.

---

## Parametric Generation — Reproducibility Rules

These rules are specific to this project and exist because each has already caused a real
failure.

### Anchor every path to `__file__`, never to the working directory

`solid2.import_scad()` resolves a bare filename against the process working directory and
then calls `.absolute()` unconditionally. That absolute path becomes what is written into
generated `.scad` files as `use <...>`. A previous sweep, run from a mapped drive, baked a
now-dead `R:\` path into all 1774 files it produced — none of them can be re-rendered.

- Anchor every input path to the module's own location.
- Generated geometry must contain **relative** references only.
- A sweep must produce identical output regardless of the directory it is launched from.

### Resolution rules that are easy to get wrong

| Mechanism | Resolves against |
| --- | --- |
| `include <x.scad>` / `use <x.scad>` | The directory of the **including file** |
| `import("mesh.stl")` | The directory of the file containing the `import()` call, then the root document's directory — **not** the working directory |
| `solid2.import_scad("x.scad")` | The process working directory, then `OPENSCADPATH` |

A duplicate mesh left anywhere on the search path will **silently shadow** the intended one.
Never leave a stale copy.

### Data-level file references

Some filenames live in *data*, not code: a `*_type_variants.csv` row names a JSON by
filename, and that JSON names an OML mesh by filename. Code and data must change in
lockstep. These couplings are invisible to static analysis and break silently — document
them in the relevant schema document.

### External tool dependencies

The generators shell out to the OpenSCAD binary, located via the `OPENSCADPATH` environment
variable. Note that this is a **non-standard use** — `OPENSCADPATH` is normally OpenSCAD's
library search path, but here it holds the binary directory and `solid_render()` depends on
that. Do not "correct" it without changing the call sites.

Environment requirements that a package manager cannot capture must be documented and
validated with a clear error, never left to fail with an obscure exception deep in a sweep.

---

## Error Handling

- Raise specific exceptions with descriptive messages that name the failing parameter
  combination or file.
- **Never catch bare `Exception` to keep a sweep running.** A geometry failure that gets
  swallowed produces a silently wrong part file, which is worse than a crash. Let it raise,
  or catch the specific exception and record the failed combination explicitly.
- Validate parameters where they are read from CSV or JSON, not deep inside geometry code
  where the error message loses the row that caused it.
- Do not silence exceptions with bare `except:` clauses.

---

## Architectural Design Patterns

### Separation of Concerns

The generator toolchain is structured in layers, each with one responsibility:

```text
┌──────────────────────────────────────────────┐
│  Parameter layer (CSV axes, shape JSON)       │  ← unit conversion lives here
├──────────────────────────────────────────────┤
│  Sweep layer (Python: iterate, name, write)   │
├──────────────────────────────────────────────┤
│  Geometry layer (OpenSCAD modules)            │  ← millimeters — see note
├──────────────────────────────────────────────┤
│  Render layer (OpenSCAD binary, STL/PNG out)  │
└──────────────────────────────────────────────┘
```

The geometry layer is OpenSCAD source, which is conventionally millimeters. That makes the
**sweep layer's emission step the file interface**: it converts SI to millimeters on the way
into generated `.scad`, in one named function. Everything above that line is SI.

- Geometry modules take parameters and produce shapes. They do no file I/O and know nothing
  about sweeps.
- Sweep functions handle iteration, naming, and output paths. They contain no geometry
  construction.
- Prefer pure functions that take parameters and return values. Reserve side effects (file
  writes, subprocess calls) for thin, clearly named boundary functions.

### Parameter passing

Parameters travel as dataclasses assembled in Python — `Parameters` and `NoseParameters`
in `fuselage_variants.py`, with a group per subsystem. IP-GEO-16 converted them from
nested dicts; see [python.md](python.md#type-hints) for why, and do not reintroduce a
dict of parameters.

They are still *flattened* into keyword arguments to cross into OpenSCAD, which has no
records. That is deliberate and is not a gap to close — OQ-GEO-1 assessed encoding the
groups as SCAD vectors and rejected it, because the encoding is discarded at the FreeCAD
port while the Python structure survives it.

---

## External Dependencies and Licensing

### License Policy

**Default to permissive open-source libraries.**

| License | Notes |
| --- | --- |
| MIT | Preferred. |
| BSD-2/3-Clause, Clear BSD | Preferred. |
| Apache 2.0 | Preferred. Includes explicit patent grant. |
| ISC | Preferred. Functionally equivalent to MIT. |
| LGPL (any) | Acceptable for a separate-process tool; avoid for linked libraries. |
| GPL (any) | Avoid for libraries. Note that OpenSCAD and FreeCAD are themselves GPL/LGPL applications invoked as **separate processes**, which does not propagate to this project's code. |
| NASA Open Source Agreement 1.3 | Acceptable, as a separate tool **or** as an imported module. OpenVSP is under NOSA 1.3, including its Python API surface (`vsp.py`, `_vsp.pyd`); the helper packages layered above it are MIT. NOSA's obligations attach to *distribution* of the covered software (§3.A), not to linkage, so using it imposes nothing on this project's code, and §3.I explicitly permits a Larger Work in which only the covered portions stay under NOSA. Read §4.B before shipping a *product* designed with it — a waiver-and-indemnity term covering the US Government, which is a liability question rather than a code-licensing one. |
| Proprietary | Avoid unless no open-source alternative exists and explicit approval is obtained. |

### Dependency Selection Criteria

1. **License** — must be permissive (see above).
2. **Maintenance** — active development or stable/complete.
3. **Minimal footprint** — prefer focused, single-purpose libraries.
4. **Source availability** — prefer source-distributed libraries over binary blobs.

Python dependencies are managed with **uv** and declared in `pyproject.toml`. See
[python.md](python.md).

---

## Code Review Standards

Review checklist:

- [ ] Tests present and meaningful, asserting on measured properties rather than exact output
- [ ] Every touched function has a committed test in the tier that can reach it — `tests/`
      (pytest) if it is importable in the venv, `src/Fuselage/freecad/check_*.py`
      (`freecadcmd`) if it touches FreeCAD — not only a scratchpad script used to check it
      once
- [ ] No production change rests on ad hoc/scratchpad verification as its only evidence
- [ ] Naming follows standards
- [ ] SI (m, s, kg, rad) used throughout internal code; imperial and millimeter values converted at the file interface only
- [ ] Exported STL/3MF is in millimeters — verify by measuring, not by inspection
- [ ] Every path anchored to `__file__`; no working-directory dependence
- [ ] Generated geometry contains relative references only — no absolute paths
- [ ] No bare `except:` and no `except Exception` that swallows a geometry failure
- [ ] Data-level file references (CSV → JSON → mesh) updated in lockstep
- [ ] No hardcoded magic numbers (use named constants)
- [ ] No backward-compatibility shims, deprecated aliases, or forwarding wrappers
- [ ] New dependency license is permissive and declared in `pyproject.toml`
- [ ] No full-sweep run required to verify the change

---

## Version Control

- **Claude does not commit.** The maintainer performs all commits, merges, and pushes. Claude uses
  read-only git only. See [CLAUDE.md](../../../CLAUDE.md) for the full rule.
- Commit messages use imperative mood: "Anchor sweep paths to `__file__`" not "Anchored…".
- Each commit is self-contained and leaves the repository in a runnable state.
- Do not commit commented-out code. Delete unused code; version control preserves history.
- Never commit regenerable output: `variant_output/`, `variant_output_original/`,
  `tools/test_fuse_output/`, `__pycache__/`, `.venv/`.
- Do commit hand-modeled geometry. Note that the stock Python `.gitignore` template's
  `parts/` and `lib/` rules silently match `src/Fuselage/parts/` and would exclude
  irreplaceable CAD — verify with `git check-ignore -v` before assuming a file is tracked.

### ⚠ No personal data and no machine-specific paths. Ever.

**No personal identifier belongs in this repository** — not in prose, not in a comment, not in
an identifier, not in a commit message, and not inside a binary's metadata. In scope:

- a contributor's name, in any form, including as the attribution for a decision;
- an email address;
- the name of a machine, a network share, or a drive mapping;
- an absolute path beneath a user profile, which carries the account name along with it.

**This is a privacy rule and it is separate from the portability rule.** [Anchor every path to
`__file__`](#anchor-every-path-to-__file__-never-to-the-working-directory) forbids absolute
paths because a dead drive mapping makes generated geometry unrenderable; that is a correctness
concern, and a path like `/opt/shared/project/...` would satisfy it while still naming someone.
Both rules apply to the same text for different reasons, and neither implies the other.

**Attribute a decision without naming anyone.** "On direct instruction", "the maintainer" and
"the project owner" each carry the same information a name would. A design document records
*what* was decided and *why*, and a reader needs neither the decider's name nor their address
to act on it. Git already records authorship; a document repeating it adds nothing and spreads
it into every file that cites the decision.

**Describe a constraint by its property, never by its identity.** Where a passage has to explain
machine-specific behavior, the explanatory force is always in the property — that storage is a
network share, that a path is in extended-length UNC form — and never in which share or which
host. Say the property. A generic placeholder for the root is acceptable where the shape of the
path is the point.

**Mechanical enforcement exists, and it is a backstop rather than the rule.**
[`tools/doc_check.py`](../../src/Fuselage/tools/doc_check.py) and
[`tools/source_spelling.py`](../../src/Fuselage/tools/source_spelling.py) both refuse any file
carrying an identity they read out of git at run time, reading `--global` as well as `--local`
because a deliberately pseudonymous local identity would otherwise hide the real one. Treat a
clean run as the floor and not the ceiling: a list-driven check only ever proves it copied its
list, so it cannot report the entry nobody gave it. The rule binds whether or not a tool catches
the violation.

**Binaries carry paths where no text search will find them.** A `.blend` stores a last-used
directory and a paste-buffer path; a render stores the file it came from in a PNG `tEXt` chunk;
a FreeCAD document stores its own save location. None of those appear in `git grep`. Use
[`tools/strip_embedded_paths.py`](../../src/Fuselage/tools/strip_embedded_paths.py) to scan and
clean them, and prefer ignoring a regenerable binary outright over committing one and cleaning
it afterwards.

**A violation is not fixed by removing it from the working tree.** It persists in every commit
whose tree contains it, an exposure that outlives the edit and can only be repaired by rewriting
history — the maintainer's decision, never Claude's, and expensive enough that avoiding the
violation is the only cheap option. `src/Fuselage/tools/history_rewrite.py` carries the mechanics
and the reasoning.

---

## Documentation and Math Formatting

### LaTeX / KaTeX in Markdown

All documentation math is rendered by KaTeX. KaTeX does not support arbitrary Unicode
inside math mode — non-ASCII characters embedded raw in math expressions cause render
errors.

**Rule: never embed non-ASCII characters inside a math span (`` $…$ `` or `$$…$$`),
including inside `\text{}` and `\mathrm{}` blocks.**

| Instead of (raw Unicode) | Use (KaTeX command) |
| --- | --- |
| `\text{mm²}` | `\text{mm}^2` |
| `\text{mm³}` | `\text{mm}^3` |
| `\text{N·mm}` | `\text{N}{\cdot}\text{mm}` |
| `\text{45°}` | `45^\circ` |

The pattern is: break `\text{}` around the special character and replace the character
with its KaTeX counterpart (`{\cdot}`, `^2`, `^3`, `^\circ`, subscripts, Greek letters).

Non-ASCII characters are allowed in **plain prose** (outside math spans): writing "mm³" or
"45°" in a sentence or table cell is fine because it is rendered as HTML, not processed by
KaTeX.

### Markdown Lint Standards

All documentation files should be free of markdownlint warnings before being presented for
review.

**Disabling rules is not permitted.** Fix the underlying formatting issue. The only rule
disabled project-wide is MD013 (line length), because the 80-character default is
unworkable for tables — suppress it in `.markdownlint.json`, not inline.

| Rule | Description | Fix |
| --- | --- | --- |
| MD024 | No two headings may have identical text | Make headings unique |
| MD031 | Fenced code blocks must be surrounded by blank lines | Add a blank line before the opening fence and after the closing fence |
| MD032 | Lists must be preceded and followed by a blank line | Add a blank line before the first list item |
| MD040 | Fenced code blocks must declare a language | Add a specifier: ` ```python `, ` ```scad `, ` ```text `, ` ```mermaid ` |
| MD060 | Table separator rows must use spaced pipes | Use `\| --- \| --- \|` — never `\|---\|---\|` |
| Mermaid syntax | Diagrams must use valid Mermaid edge syntax | Use `-- "label" -->` for labeled directed edges |

**Canonical lint tool (run from the repo root):**

```text
npx markdownlint-cli2 "doc/**/*.md"
```

### Numerical Substitution in Derivations

Substitute numerical values for constants only in **worked examples** — never in derivation
steps or general formulae. Premature substitution obscures the mathematical structure and
makes the formula inapplicable to other parameter regimes.

- **Derivation:** keep symbols — $w = U \cdot w_{\mathrm{unit}}$
- **Example:** substitute — $w = 0.150\,\text{m}$ at $U = 1.5$, $w_{\mathrm{unit}} = 0.100\,\text{m}$

### Document types and where they live

| Type | Location | Skill |
| --- | --- | --- |
| Roadmap | `doc/roadmap.md` | `/roadmap` |
| Architecture | `doc/architecture/` | `/arch` |
| Module design | `doc/design/` | `/design` |
| Algorithms | `doc/algorithms/` | `/algo` |
| Parameter schemas | `doc/schemas/` | `/schema` |
| Implementation plans | `doc/implementation/` | `/impl` |
| Open questions | inside design documents | `/oq` |
| Coding guidelines | `doc/guidelines/` | — |

Narrative design rationale lives in the **wiki**, a separate repository
(`modular-sUAS.wiki`). The wiki is not a design authority: where it and a design document
disagree, the design document wins and the wiki is corrected.
