yJjDoAZuae/modular-sUAS/(commit log)

2026-08-06 image rendering refactored into fuselage_variants.py, color and camera position updates, sweep restarting and parallelization
2026-08-06 implemented key/value interfaces for fuselage_variants.py
2026-08-06 render OpenSCAD "driver" files
2026-08-06 parameter dataclasses, fixed cowl drivers
2026-08-07 architecture planning for freecad migration, renamed nozzle diameter to extrusion width for clarity
2026-08-08 openvsp export to step file prototype
2026-09-22 nose plate implementation
